aandreuisabal/open-sensor-network/README.md

open-sensor-network
===================

My final degree project for the Pompeu Fabra University
