aandreuisabal/open-sensor-network/Thesis/UPF_cover.docx

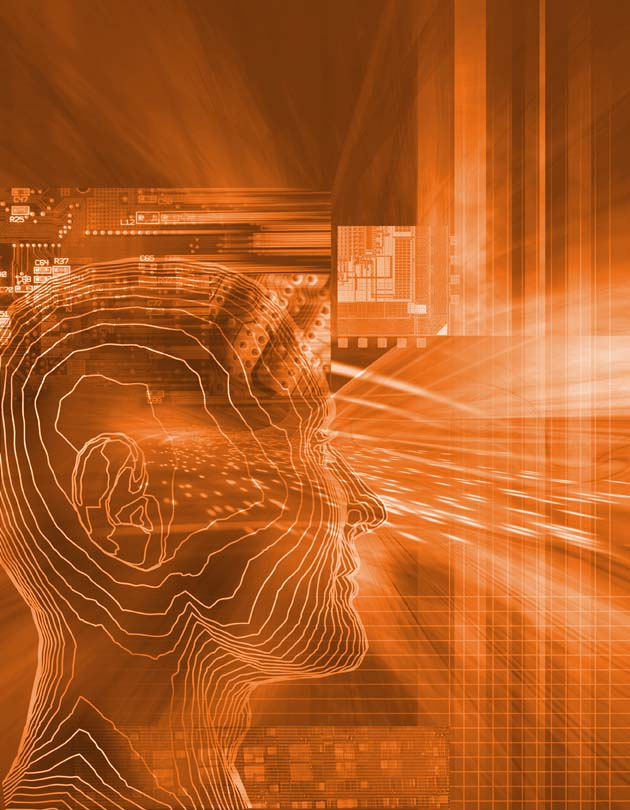
[picture p29: figure]

OPEN SENSOR NETWORK

Andreu Isábal, Alejandro

# Curs 2012-2013

Director: JAUME BARCELÓ VICENS

# GRAU EN ENGINYERIA TELEMÀTICA

Treball de Fi de Grau

# GRAU EN ENGINYERIA EN xxxxxxxxxxxx
