aandreuisabal/open-sensor-network/Thesis/Figures/egg.png

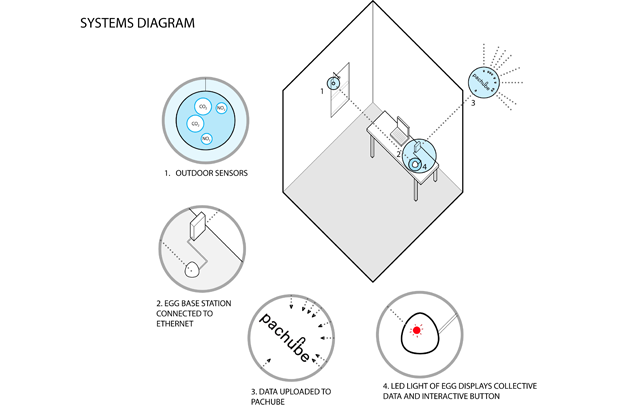
Thesis/Figures/egg.png
