aandreuisabal/open-sensor-network/Thesis/Figures/xbee_net.png

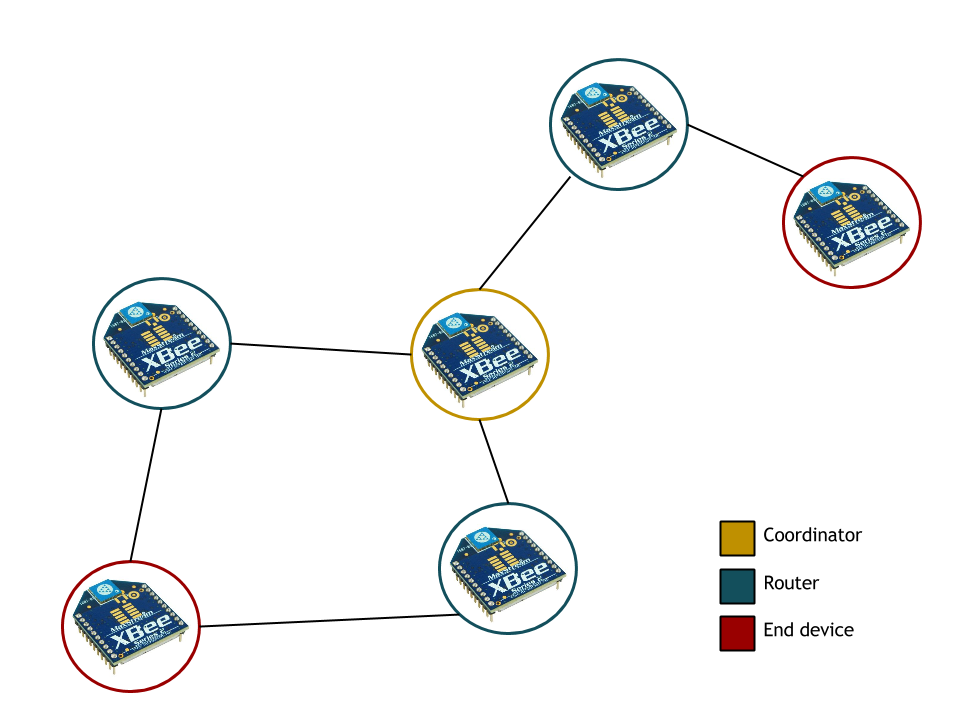
Thesis/Figures/xbee_net.png
