aandreuisabal/open-sensor-network/(list of files, drawings)

Other design files:
Schematics/sensornode.fzz
Schematics/serverside.fzz
Schematics/standalonexbee.fzz
