aandreuisabal/open-sensor-network/(commit log)

2013-07-16 Includes Fritzing schematics.
    [sensornode.fzz, serverside.fzz, standalonexbee.fzz]
2013-07-16 Fixes a couple of figures.
